idaohang/stm32gps-stop/Documents/KEIL工程设置.docx

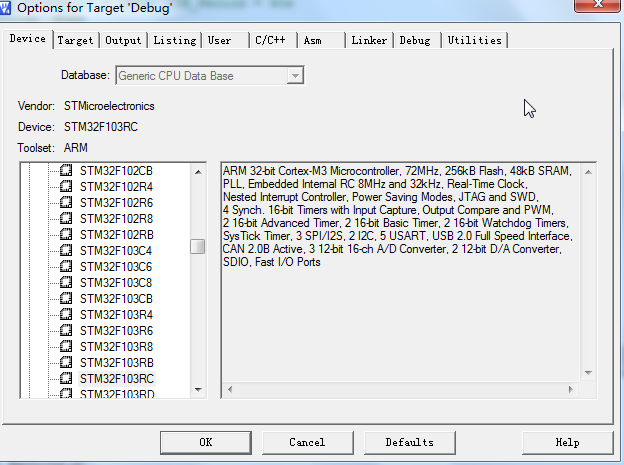
[picture p1: figure]
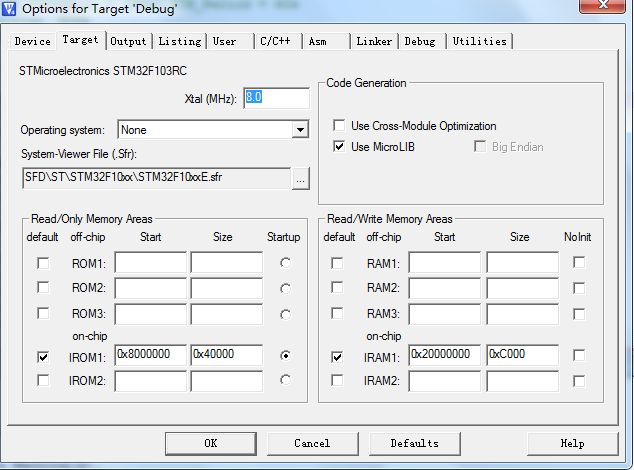
[picture p2: figure]
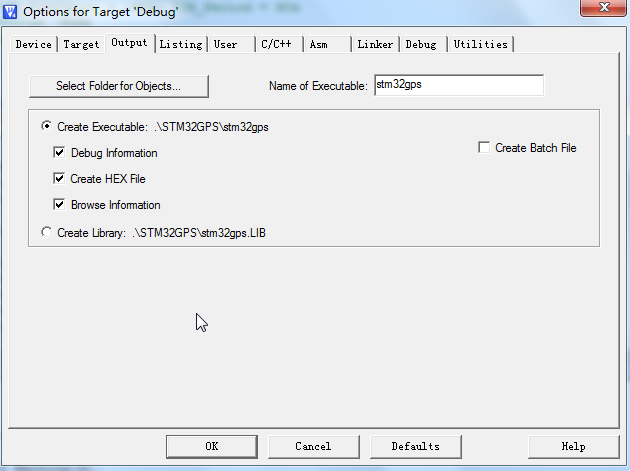
[picture p3: figure]
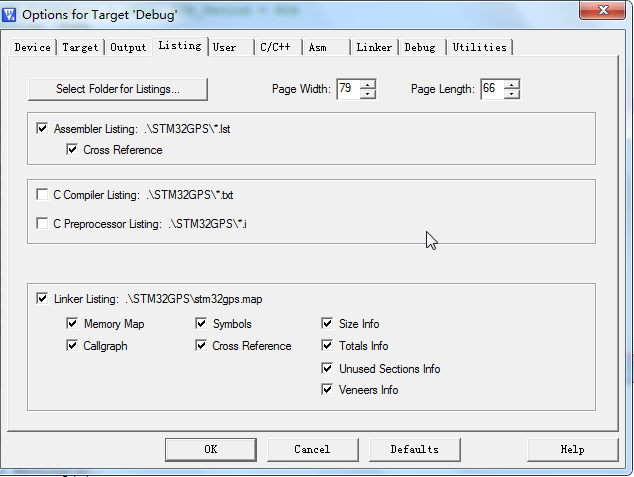
[picture p4: figure]
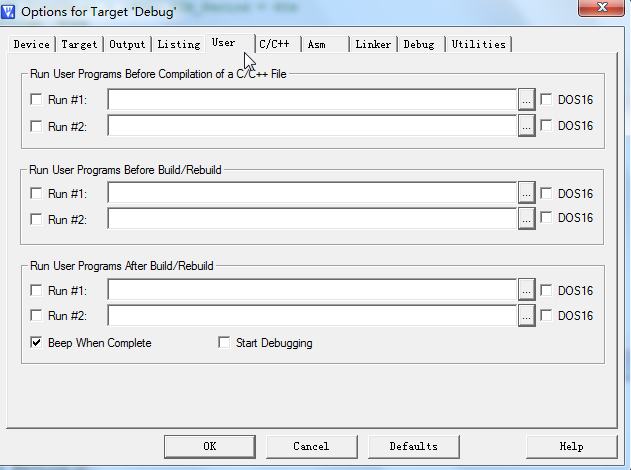
[picture p5: figure]
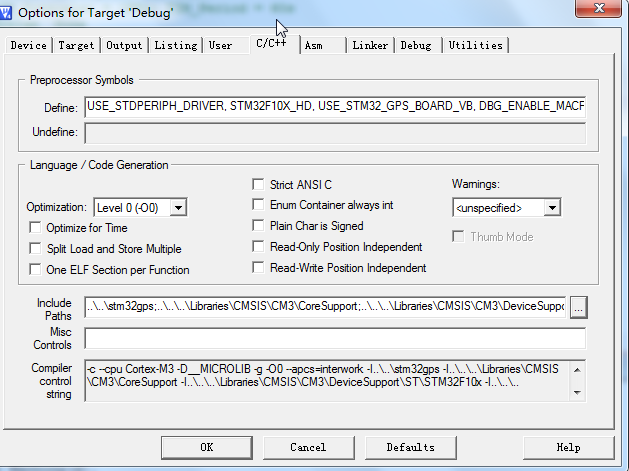
[picture p6: figure]

..\..\stm32gps;..\..\..\Libraries\CMSIS\CM3\CoreSupport;..\..\..\Libraries\CMSIS\CM3\DeviceSupport\ST\STM32F10x;..\..\..\Libraries\STM32F10x_StdPeriph_Driver\inc;..\..\..\Utilities\STM32_GPS;..\..\..\Utilities\STM32_GPS\STM32_GPS_BOARD_VA;..\..\..\Utilities\STM32_GPS\Common;..\..\..\Utilities\SIM800L;..\..\..\Utilities\SIM28M;..\..\..\Utilities\USART;..\..\..\Utilities

USE_STDPERIPH_DRIVER, STM32F10X_HD, USE_STM32_GPS_BOARD_VB, DBG_ENABLE_MACRO

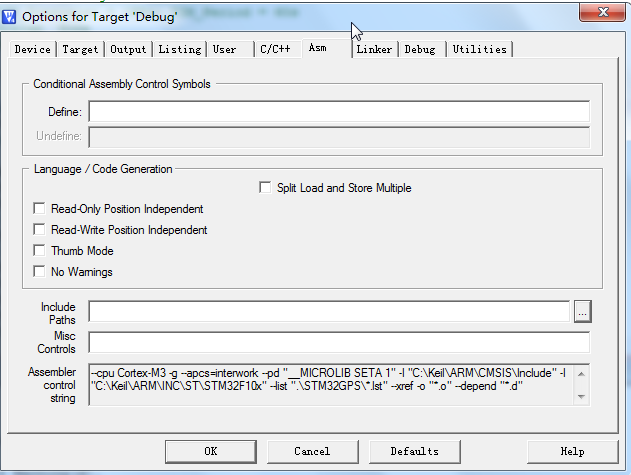
[picture p7: figure]
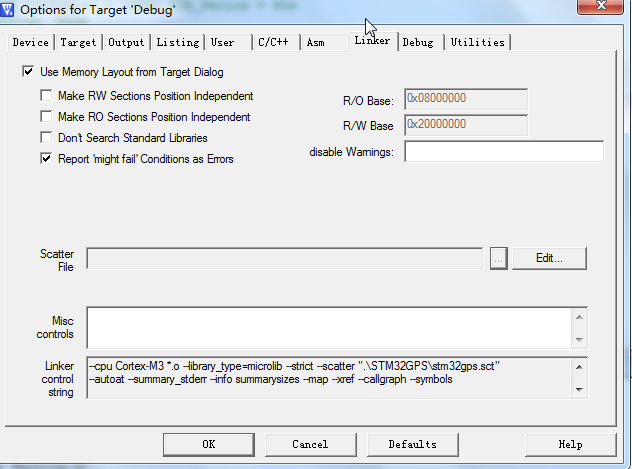
[picture p8: figure]
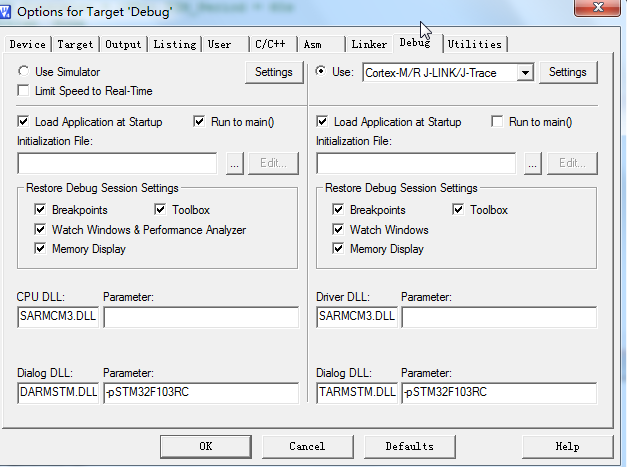
[picture p9: figure]
