idaohang/stm32gps-stop/Project/CubeMX/stm32gps_VB.jpg

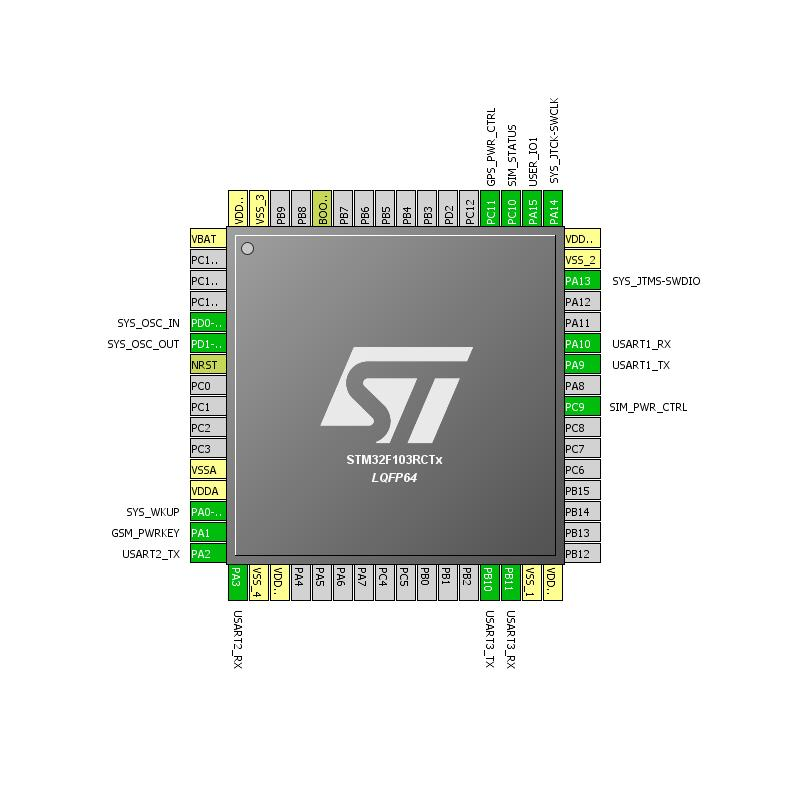
Project/CubeMX/stm32gps_VB.jpg
