idaohang/stm32gps-stop/Documents/SCHEMATIC1 _ GPRS&CPU.pdf

5

4

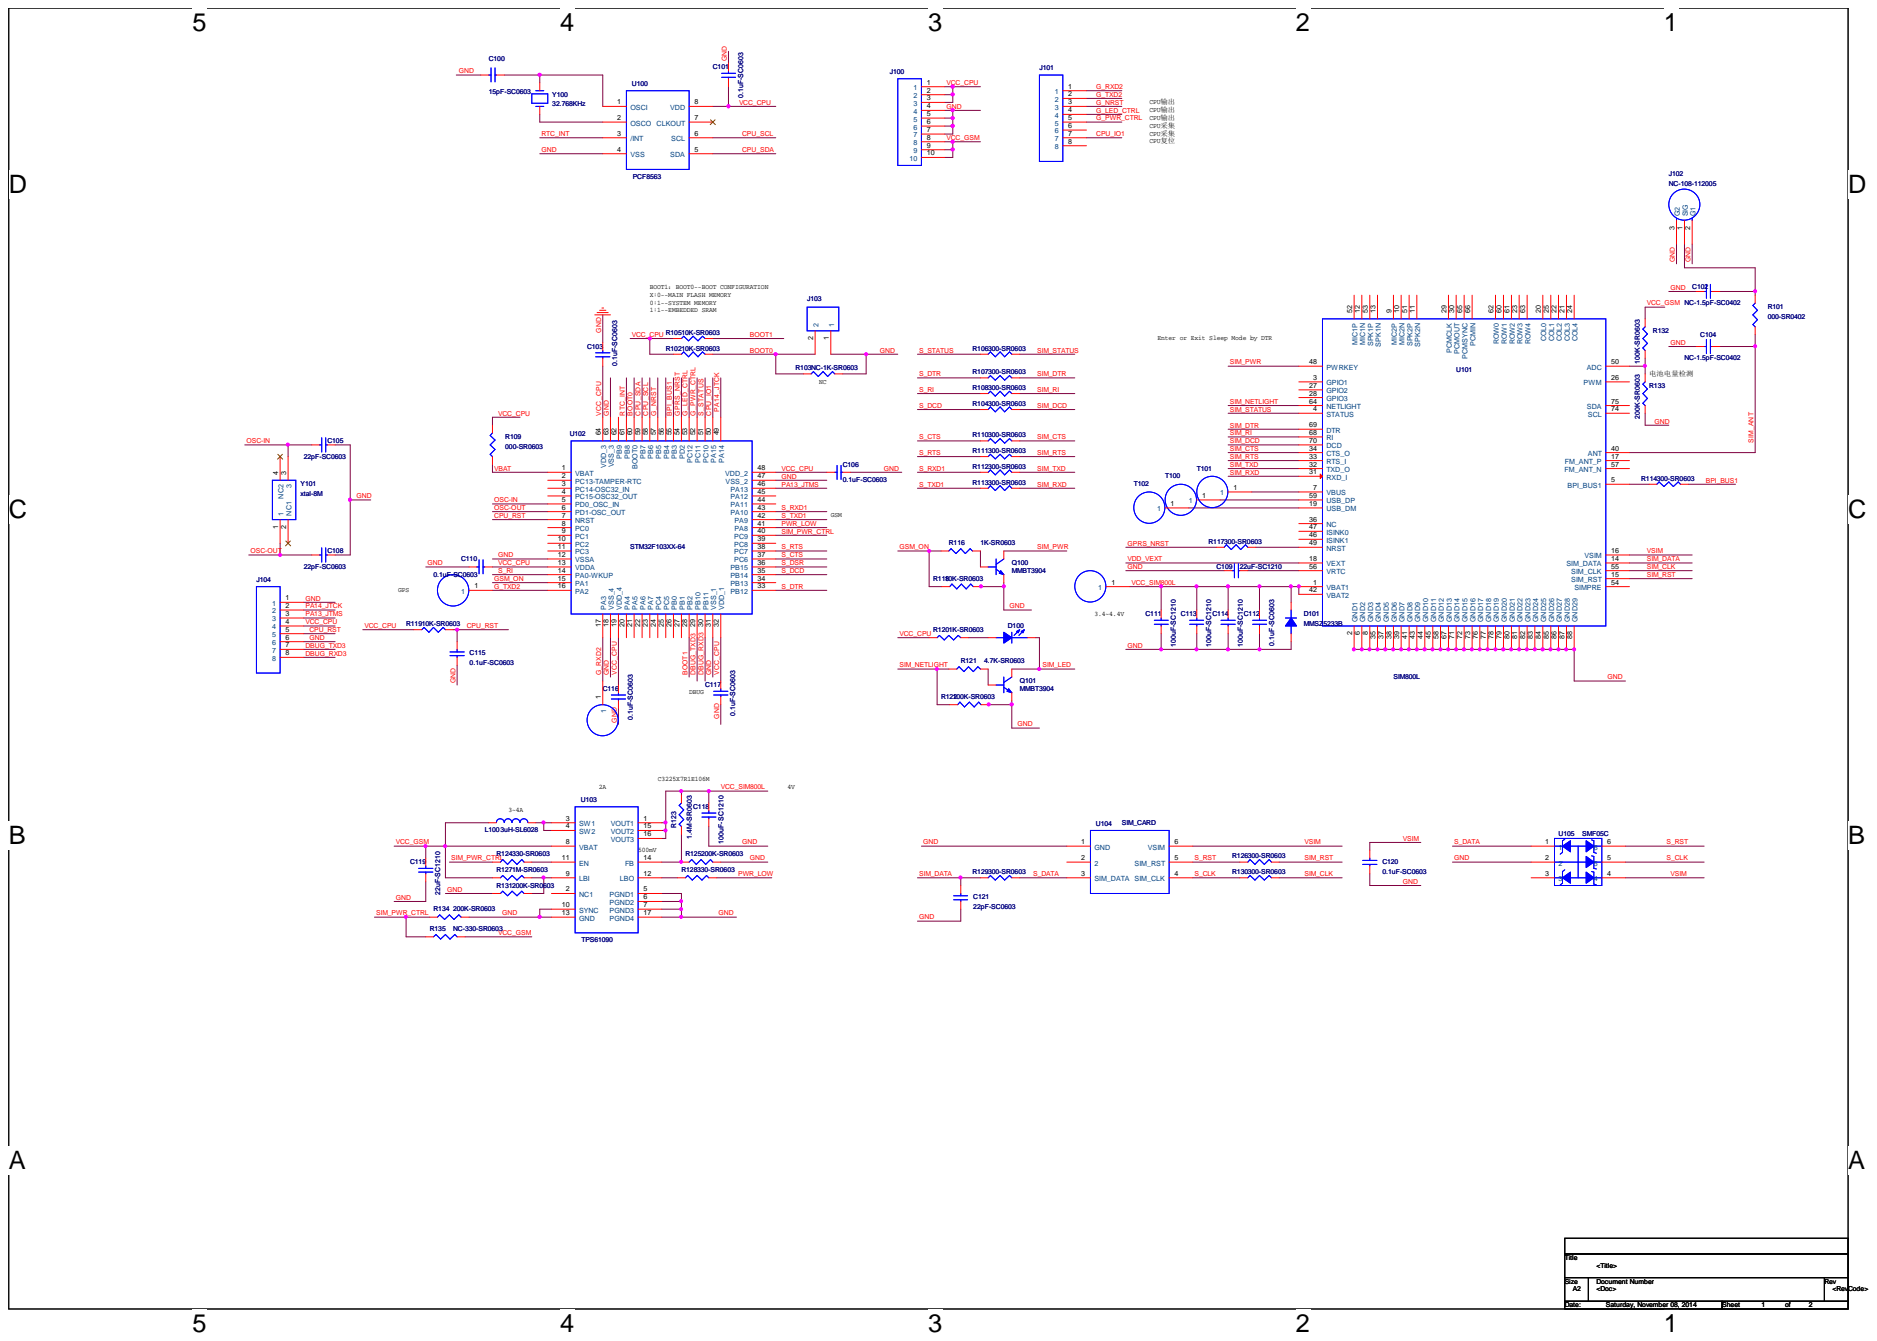
[picture p21: page 1]

Enter or Exit Sleep Mode by DTR
