idaohang/stm32gps-stop/Documents/SCHEMATIC1 _ GPS.pdf

5

4

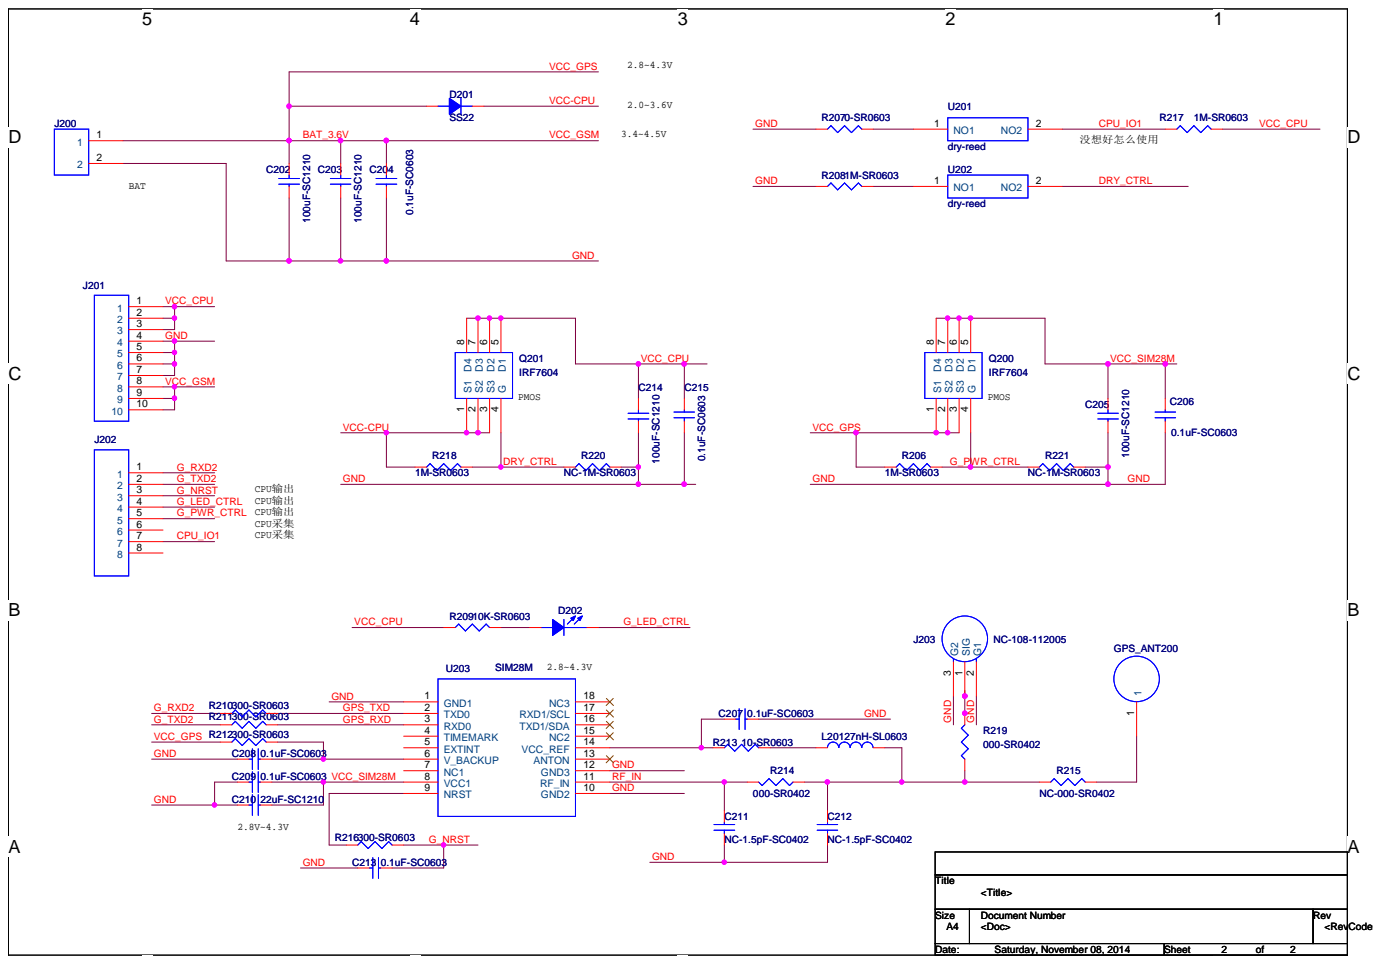
[picture p22: page 1]
