idaohang/stm32gps-stop/Documents/gprs-gps.pdf

5

4

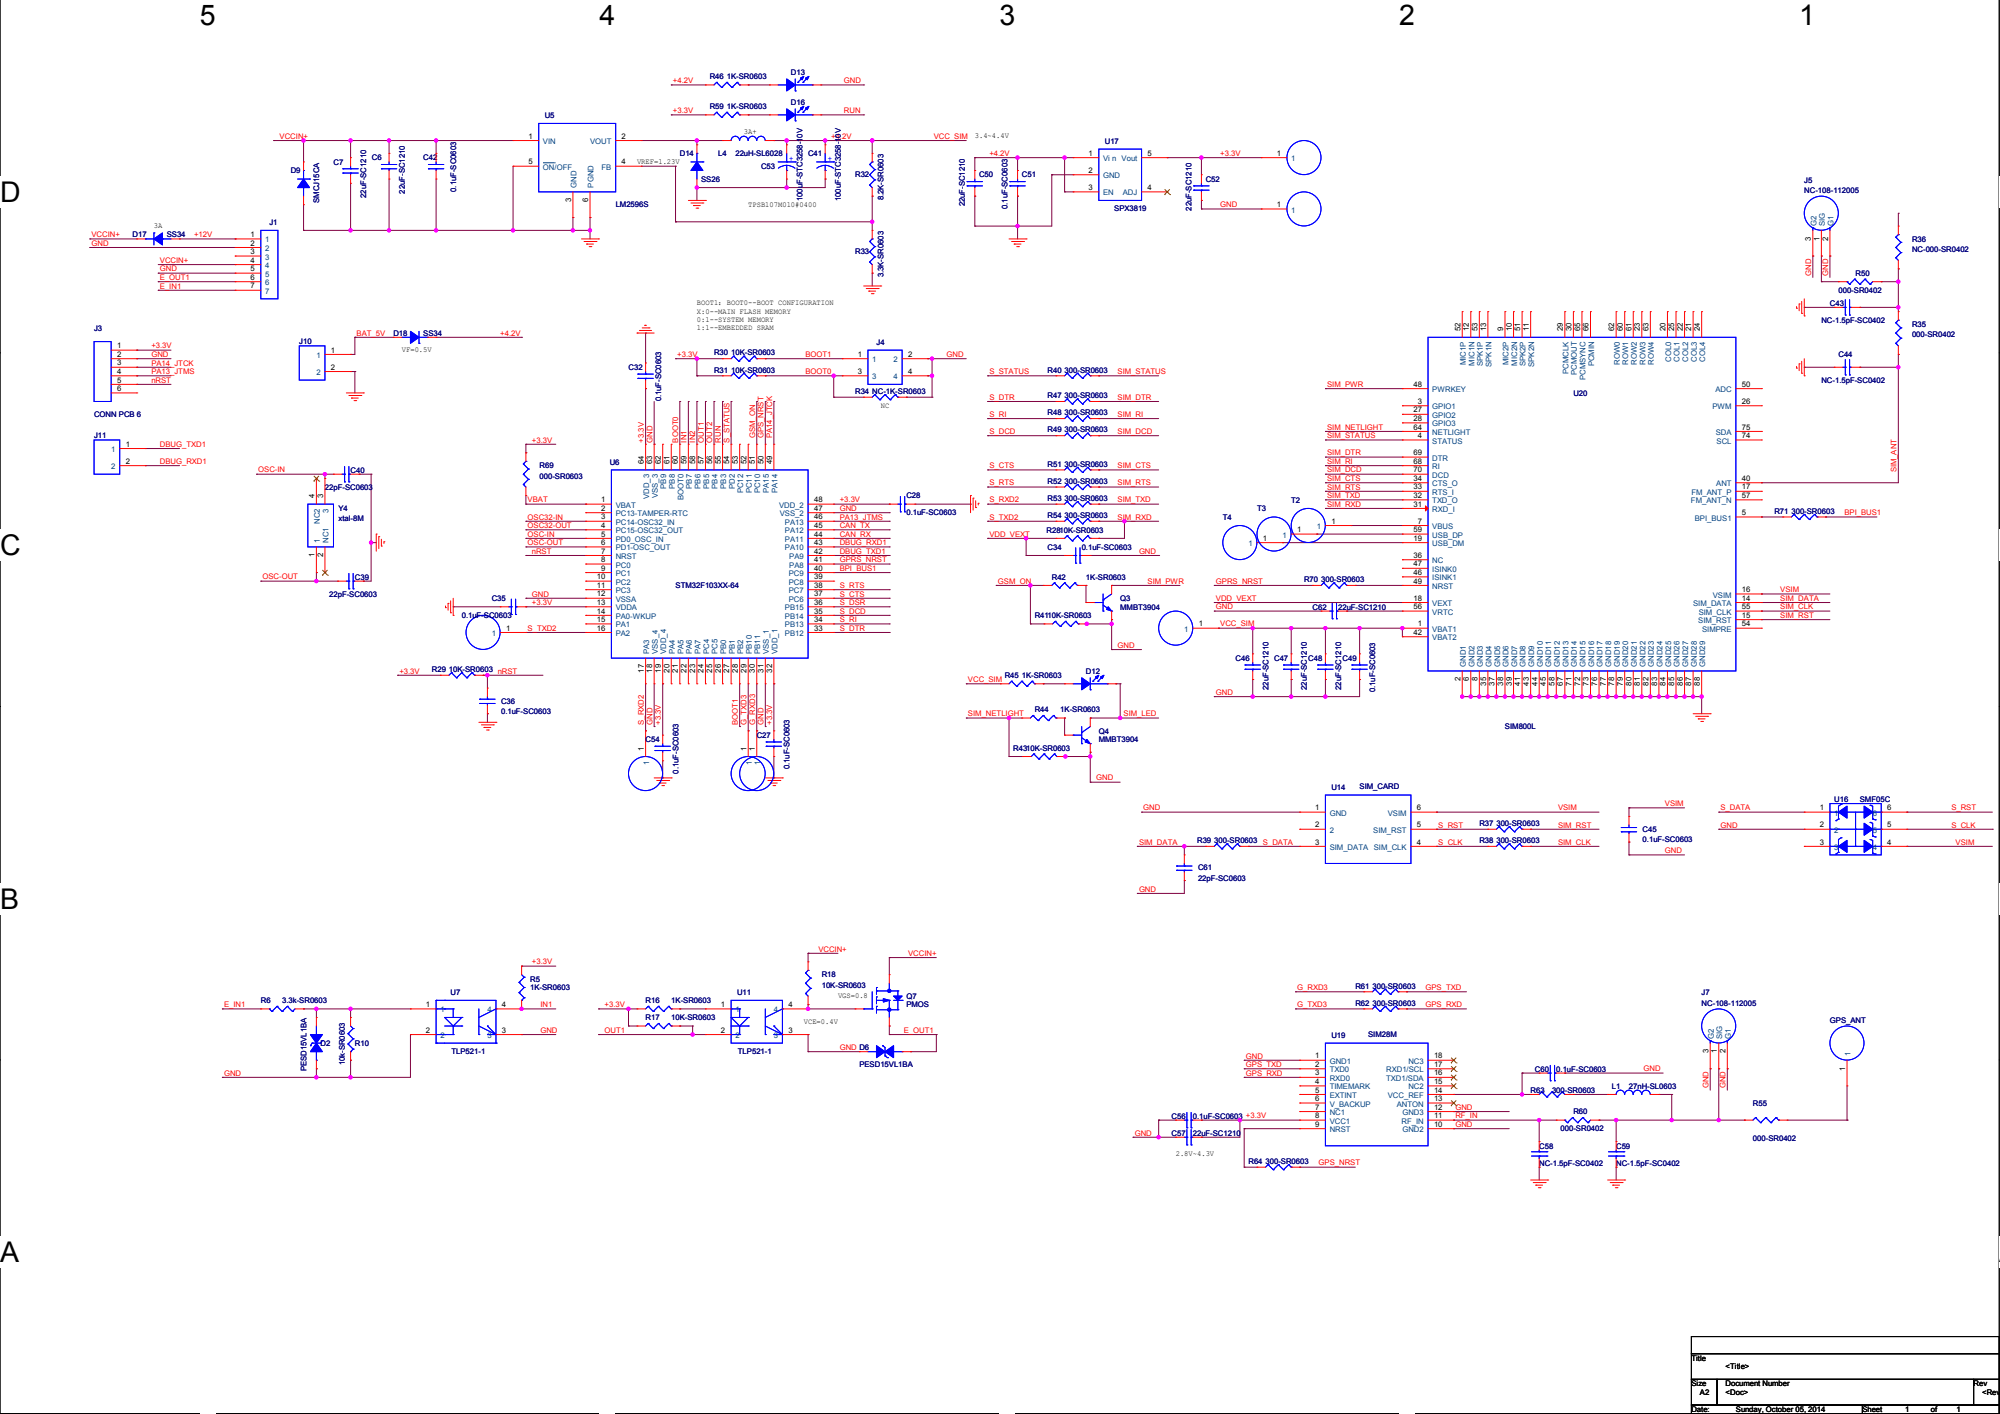
[picture p23: page 1]
