idaohang/stm32gps-stop/Project/stm32gps/gpio.h

/**
  ******************************************************************************
  * File Name          : gpio.h
  * Date               : 10/11/2014 21:37:12
  * Description        : This file contains all the functions prototypes for 
  *                      the gpio  
  ******************************************************************************
  *
  * COPYRIGHT(c) 2014 STMicroelectronics
  *
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
  ******************************************************************************
  */
/* Define to prevent recursive inclusion -------------------------------------*/
#ifndef __gpio_H
#define __gpio_H
#ifdef __cplusplus
 extern "C" {
#endif

/* Includes ------------------------------------------------------------------*/
#include "stm32f10x.h"
#include "stm32f10x_gpio.h"
#include "stm32f10x_rcc.h"
void MX_GPIO_Init(void);
void MX_GPIO_DeInit(void);
#ifdef __cplusplus
}
#endif
#endif /*__ gpio_H */

/**
  * @}
  */

/**
  * @}
  */

/************************ (C) COPYRIGHT STMicroelectronics *****END OF FILE****/
