idaohang/stm32gps-stop/Utilities/STM32_GPS/stm32gps_board.h

/**
  ******************************************************************************
  * @file    stm32gps_board.h
  * @author  MCD Application Team
  * @version V4.5.0
  * @date    07-March-2011
  * @brief   Header file for stm32gps_board.c module.
  ******************************************************************************
  */ 
  
/* Define to prevent recursive inclusion -------------------------------------*/
#ifndef __STM32GPS_BOARD_H
#define __STM32GPS_BOARD_H

#ifdef __cplusplus
 extern "C" {
#endif 

/* Includes ------------------------------------------------------------------*/


typedef enum 
{
  LED1 = 0,
  LED2 = 1,
  LED3 = 2,
  LED4 = 3
} Led_TypeDef;

typedef enum 
{  
  BUTTON_KEY = 0,
} Button_TypeDef;

typedef enum 
{  
  BUTTON_MODE_GPIO = 0,
  BUTTON_MODE_EXTI = 1
} ButtonMode_TypeDef;
/*
typedef enum 
{
	COM1_GPS = 0,
	COM2_GSM = 1,
	COM3_DEBUG = 2
} COM_TypeDef; 
*/
typedef enum 
{
	COM1 = 0,
	COM2 = 1,
	COM3 = 2
} COM_TypeDef; 


/** 
  * @brief  Uncomment the line corresponding to the STMicroelectronics evaluation
  *   board used in your application.
  *   
  *  Tip: To avoid modifying this file each time you need to switch between these
  *       boards, you can define the board in your toolchain compiler preprocessor.    
  */ 
#if !defined (USE_STM32_GPS_BOARD_VA) && !defined (USE_STM32_GPS_BOARD_VB)
 //#define USE_STM32_GPS_BOARD_VA
 //#define USE_STM32_GPS_BOARD_VB
#endif

#ifdef USE_STM32_GPS_BOARD_VA
 #include "stm32f10x.h"
 #include "STM32_GPS_BOARD_VA/stm32_gps_board.h"
#elif defined USE_STM32_GPS_BOARD_VB
 #include "stm32f10x.h"
 #include "STM32_GPS_BOARD_VB/stm32_gps_board.h" 
#else 
 #error "Please select first the STM32 GPS board to be used (in stm32_eval.h)"
#endif                      



#ifdef __cplusplus
}
#endif


#endif /* __STM32GPS_BOARD_H */

/**
  * @}
  */ 



/******************* (C) COPYRIGHT 2011 STMicroelectronics *****END OF FILE****/
