idaohang/stm32gps-stop/(commit log)

2014-11-22 [Y] Add Delay before Check Remove Flag
    [Y] Add Delay before Check Remove Flag; resolve login msg loop error
    [GSM_App.c, main.c, stm32gps_config.h, usart.c]
2014-11-22 [Y]Resolve GPS problem
    [Y]Resolve GPS problem
    [main.c]
